cartagena/TubeDeck/(commit log)

2026-09-28 Add TubeDeck Fusion 360 script and OpenSCAD model
    TubeDeck.py builds the CRT-TV housing (shell, faceplate, collar, cradle,
    rear cover, feet) plus a combined test plate in Fusion 360.
    TubeDeck.scad is the equivalent OpenSCAD model.
    Claude-Session: https://claude.ai/code/session_017qZDJ9wfgEJesWciwg7HAR
    [TubeDeck.scad]
2026-09-28 Add build guide draft with Overview section
    docs/build-guide.md outlines all twelve sections and has the Overview
    written: what TubeDeck is, at-a-glance specs, the parts of the case with
    an exploded view, and print and assembly times. The parts table links the
    items used for the prototype.
    CLAUDE.md sets the writing guidelines for the documentation.
    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
2026-09-28 Complete the Parts & materials section of the build guide
    Adds the Raspberry Pi 4 Model B, screws, zip ties, power supply, PLA and
    super glue to the parts table, a note on differing monitor dimensions,
    and notes the tools still to confirm.
    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
